adafruit/Adafruit-PiCowbell-DVI-Output/Adafruit PiCowbell DVI Output for Pico.brd

## EAGLE design Adafruit PiCowbell DVI Output for Pico.brd (2023-05-16)

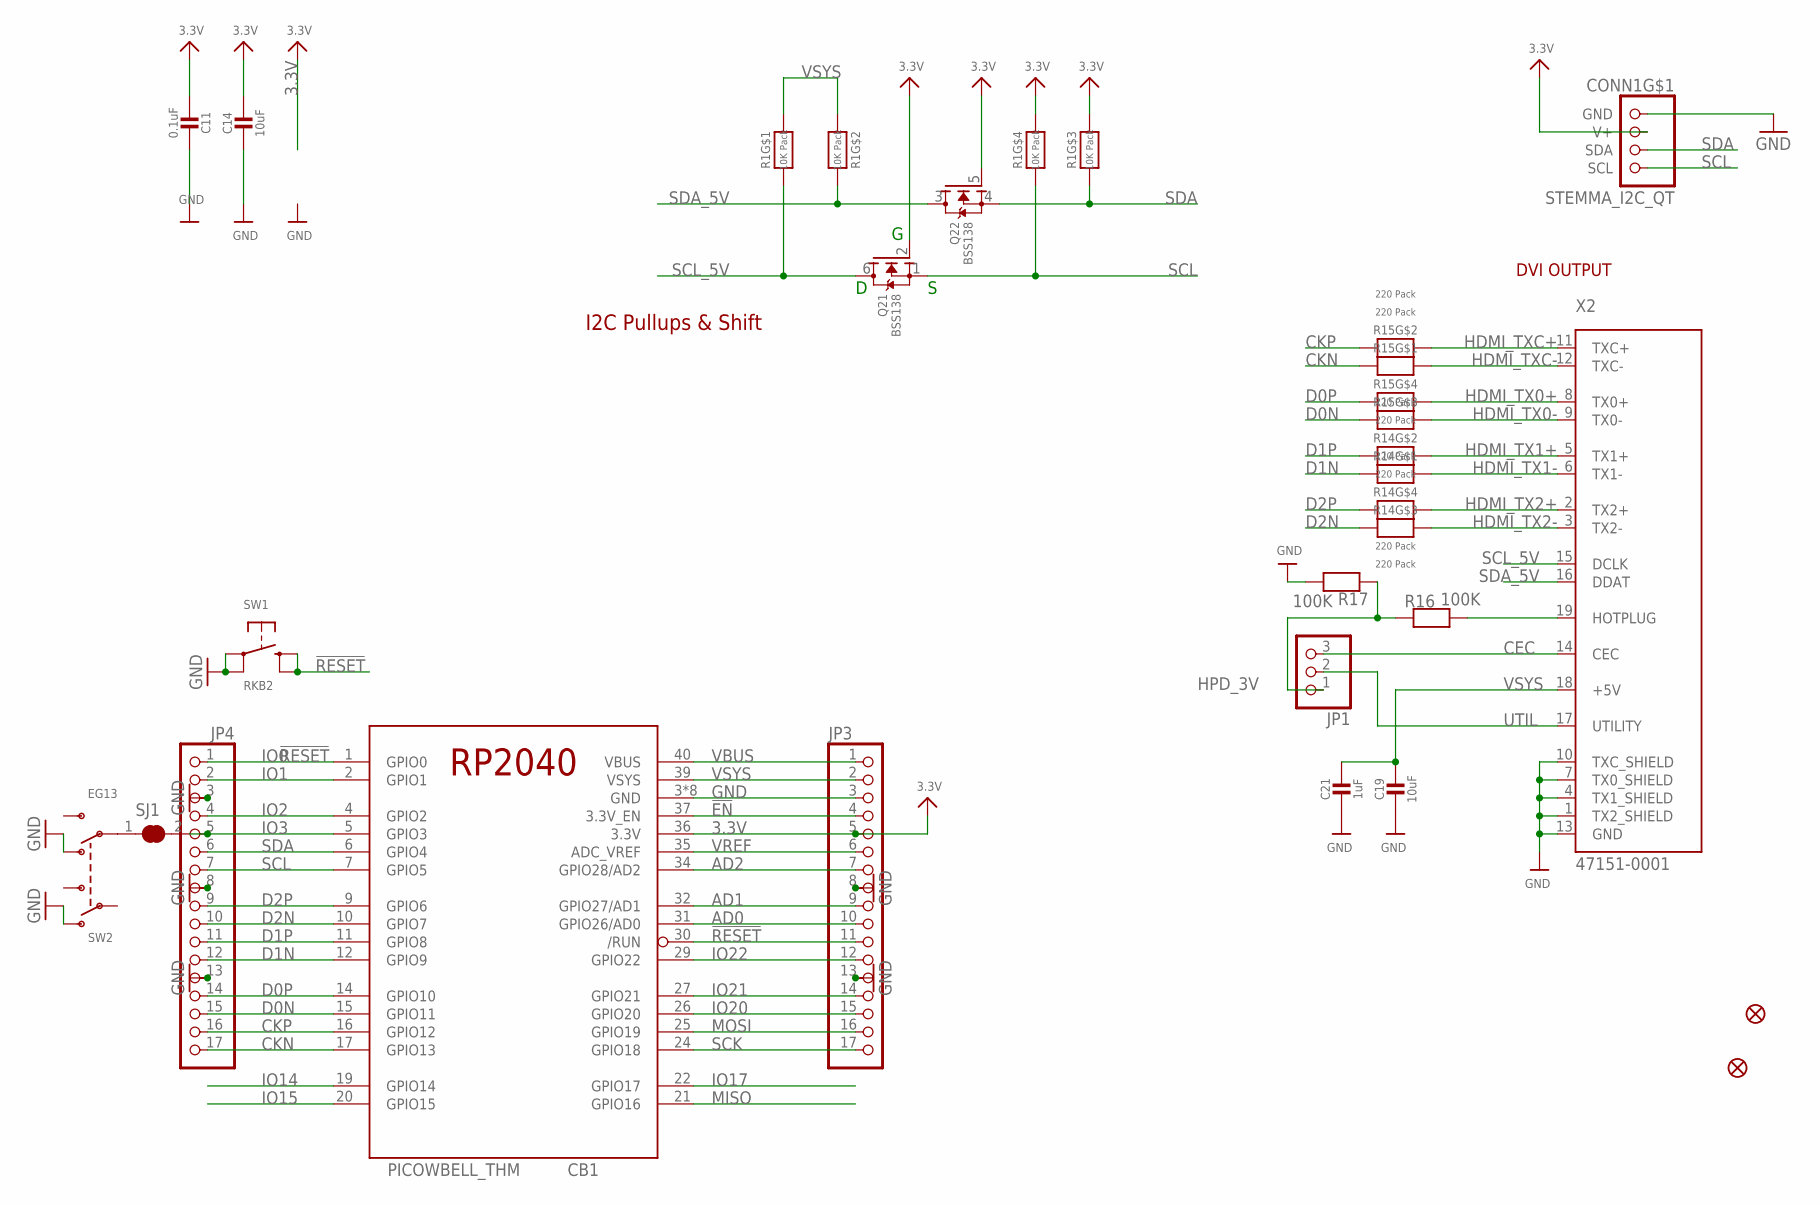
[picture p2: schematic Adafruit PiCowbell DVI Output for Pico.sch]

Parts:
C11: 0.1uF; 0603-NO
C14, C19: 10uF; 0805-NO
C21: 1uF; 0603-NO
CB1: PICOWBELL_THM
CONN1: STEMMA_I2C_QT; JST_SH4
FID1, FID2: FIDUCIAL_1MM
JP1: HEADER-1X3ROUND; 1X03_ROUND
JP3, JP4: HEADER-1X17; 1X17_ROUND70
Q2: BSS138; SOT363
R1: 10K Pack; RESPACK_4X0603
R14, R15: 220 Pack; RESPACK_4X0603
R16, R17: 100K; 0603-NO
SJ1: SOLDERJUMPER_CLOSED; SOLDERJUMPER_CLOSEDWIRE
SW1: RKB2; BTN_RKB2_4.6X2.8
SW2: EG13; EG1390
X2: 47151-0001; MINIHDMI_CNCTECH

Connections:
3.3V: C11.2, C14.1, CB1.36 (3.3V), CONN1.2 (V+), JP3.5, Q2.2 (G), Q2.5 (G), R1.5 (2), R1.6 (2)
!EN: CB1.37 (3.3V_EN), JP3.4
!RESET: CB1.30 (/RUN), JP3.11, SW1.B (S), SW1.B' (S1)
AD0: CB1.31 (GPIO26/AD0), JP3.10
AD1: CB1.32 (GPIO27/AD1), JP3.9
AD2: CB1.34 (GPIO28/AD2), JP3.7
CEC: JP1.3, X2.14 (CEC)
CKN: CB1.17 (GPIO13), JP4.17, R15.8 (2)
CKP: CB1.16 (GPIO12), JP4.16, R15.7 (2)
D0N: CB1.15 (GPIO11), JP4.15, R15.6 (2)
D0P: CB1.14 (GPIO10), JP4.14, R15.5 (2)
D1N: CB1.12 (GPIO9), JP4.12, R14.8 (2)
D1P: CB1.11 (GPIO8), JP4.11, R14.7 (2)
D2N: CB1.10 (GPIO7), JP4.10, R14.6 (2)
D2P: CB1.9 (GPIO6), JP4.9, R14.5 (2)
GND: C11.1, C14.2, C19.2, C21.2, CB1.3 (GND), CB1.8 (GND), CB1.13 (GND), CB1.18 (GND), CB1.23 (GND), CB1.28 (GND), CB1.33 (GND), CB1.38 (GND), CONN1.1 (GND), JP3.3, JP3.8, JP3.13, JP4.3, JP4.8, JP4.13, R17.2, SW1.A, SW1.A' (P1), SW2.O1, SW2.O2, X2.1 (TX2_SHIELD), X2.4 (TX1_SHIELD), X2.7 (TX0_SHIELD), X2.10 (TXC_SHIELD), X2.13 (GND), X2.MNT1 (GND), X2.MNT2 (GND), X2.MNT3 (GND), X2.MNT4 (GND)
HDMI_TX0+: R15.4 (1), X2.8 (TX0+)
HDMI_TX0-: R15.3 (1), X2.9 (TX0-)
HDMI_TX1+: R14.2 (1), X2.5 (TX1+)
HDMI_TX1-: R14.1, X2.6 (TX1-)
HDMI_TX2+: R14.4 (1), X2.2 (TX2+)
HDMI_TX2-: R14.3 (1), X2.3 (TX2-)
HDMI_TXC+: R15.2 (1), X2.11 (TXC+)
HDMI_TXC-: R15.1, X2.12 (TXC-)
HPD: R16.2, X2.19 (HOTPLUG)
HPD_3V: JP1.1, R16.1, R17.1
IO0: CB1.1 (GPIO0), JP4.1
IO1: CB1.2 (GPIO1), JP4.2
IO2: CB1.4 (GPIO2), JP4.4
IO3: CB1.5 (GPIO3), JP4.5, SJ1.2
IO14: CB1.19 (GPIO14)
IO15: CB1.20 (GPIO15)
IO17: CB1.22 (GPIO17)
IO20: CB1.26 (GPIO20), JP3.15
IO21: CB1.27 (GPIO21), JP3.14
IO22: CB1.29 (GPIO22), JP3.12
MISO: CB1.21 (GPIO16)
MOSI: CB1.25 (GPIO19), JP3.16
unnamed: SJ1.1, SW2.P2
SCK: CB1.24 (GPIO18), JP3.17
SCL: CB1.7 (GPIO5), CONN1.4 (SCL), JP4.7, Q2.1 (S), R1.4 (1)
SCL_5V: Q2.6 (D), R1.8 (2), X2.15 (DCLK)
SDA: CB1.6 (GPIO4), CONN1.3 (SDA), JP4.6, Q2.4 (S), R1.3 (1)
SDA_5V: Q2.3 (D), R1.7 (2), X2.16 (DDAT)
UTIL: JP1.2, X2.17 (UTILITY)
VBUS: CB1.40 (VBUS), JP3.1
VREF: CB1.35 (ADC_VREF), JP3.6
VSYS: C19.1, C21.1, CB1.39 (VSYS), JP3.2, R1.1, R1.2 (1), X2.18 (+5V)

Notes on the sheet:
DVI OUTPUT
I2C Pullups & Shift

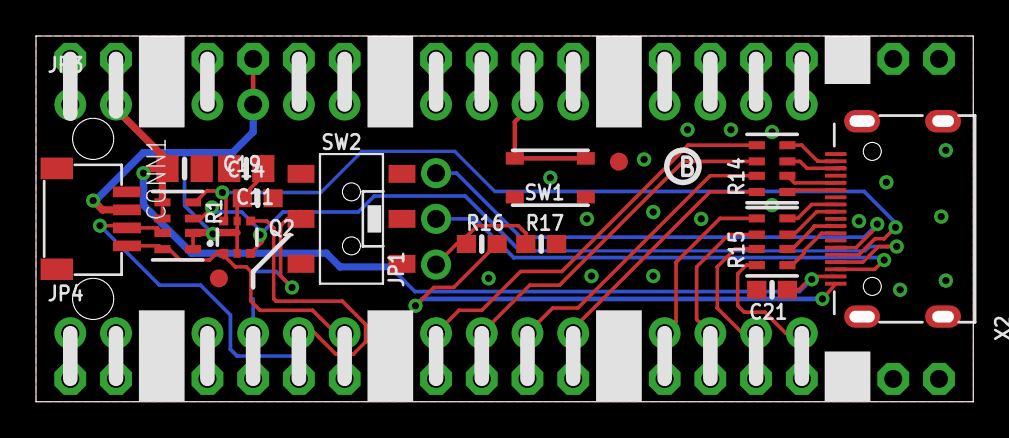
[picture p3: board Adafruit PiCowbell DVI Output for Pico.brd from above]

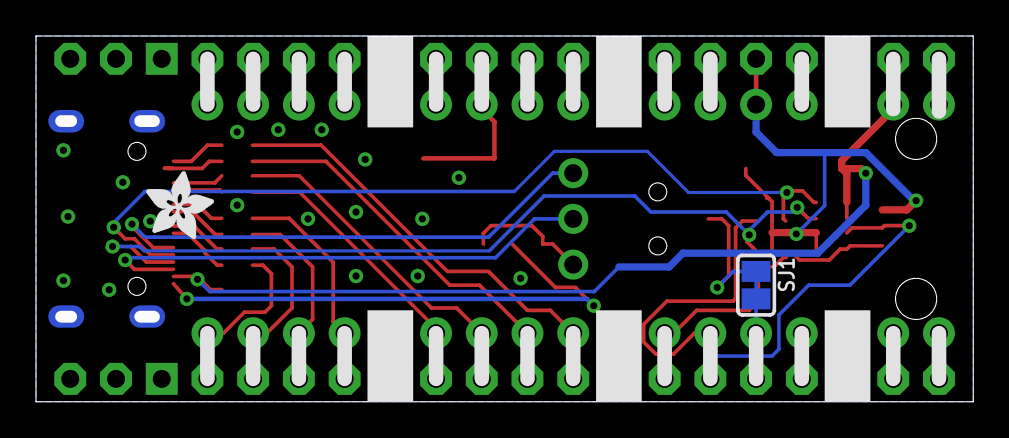
[picture p4: board Adafruit PiCowbell DVI Output for Pico.brd from below]

Board: 2 copper layers, 52.1 x 20.3 mm, 97 parts (39 on the bottom side), 44 nets.

Other parts of the board:
FRAME: ADAFRUIT_3.5MM
PLABEL36: PLABEL36
PLABEL37: PLABEL37
PLABEL38: PLABEL38
PLABEL39: PLABEL39
PLABEL40: PLABEL40
PLABEL41: PLABEL41
PLABEL42: PLABEL42
PLABEL43: PLABEL43
PLABEL44: PLABEL44
PLABEL45: PLABEL45
PLABEL46: PLABEL46
PLABEL47: PLABEL47
PLABEL48: PLABEL48
PLABEL49: PLABEL49
PLABEL50: PLABEL50
PLABEL51: PLABEL51
PLABEL52: PLABEL52
PLABEL53: PLABEL53
PLABEL54: PLABEL54
PLABEL55: PLABEL55
PLABEL56: PLABEL56
PLABEL57: PLABEL57
PLABEL58: PLABEL58
PLABEL59: PLABEL59
PLABEL60: PLABEL60
PLABEL61: PLABEL61
PLABEL62: PLABEL62
PLABEL63: PLABEL63
PLABEL64: PLABEL64
PLABEL65: PLABEL65
PLABEL66: PLABEL66
PLABEL67: PLABEL67
PLABEL68: PLABEL68
PLABEL69: PLABEL69
PLABEL70: PLABEL70
PLABEL71: PLABEL71
PLABEL72: PLABEL72
PLABEL73: PLABEL73
PLABEL74: PLABEL74
PLABEL75: PLABEL75
PLABEL76: PLABEL76
PLABEL77: PLABEL77
PLABEL78: PLABEL78
PLABEL79: PLABEL79
PLABEL80: PLABEL80
PLABEL81: PLABEL81
PLABEL82: PLABEL82
PLABEL83: PLABEL83
PLABEL84: PLABEL84
PLABEL85: PLABEL85
PLABEL86: PLABEL86
PLABEL87: PLABEL87
PLABEL88: PLABEL88
PLABEL89: PLABEL89
PLABEL90: PLABEL90
PLABEL91: PLABEL91
PLABEL92: PLABEL92
PLABEL93: PLABEL93
PLABEL94: PLABEL94
PLABEL95: PLABEL95
PLABEL96: PLABEL96
PLABEL97: PLABEL97
PLABEL98: PLABEL98
PLABEL99: PLABEL99
PLABEL100: PLABEL100
PLABEL101: PLABEL101
PLABEL102: PLABEL102
PLABEL103: PLABEL103
PLABEL104: PLABEL104
PLABEL105: PLABEL105
PLABEL106: PLABEL106
PLABEL107: PLABEL107
PLABEL108: PLABEL108
PLABEL109: PLABEL109
U$10: PCBFEAT-REV-040
